GuillaumeRossolini/griotte/doc/img/2024-09-30_overview.jpg

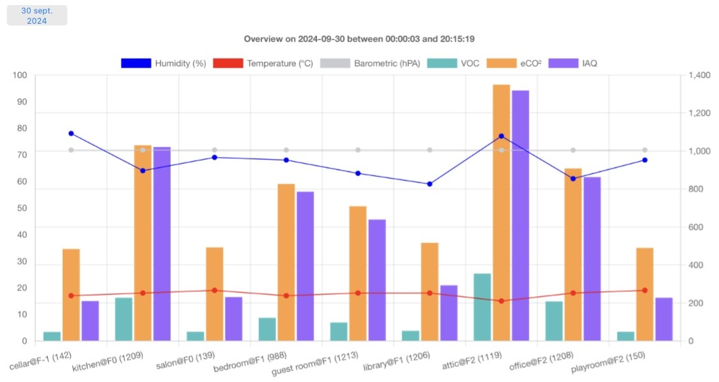
doc/img/2024-09-30_overview.jpg
