GuillaumeRossolini/griotte/doc/img/2025-03-06_overview.png

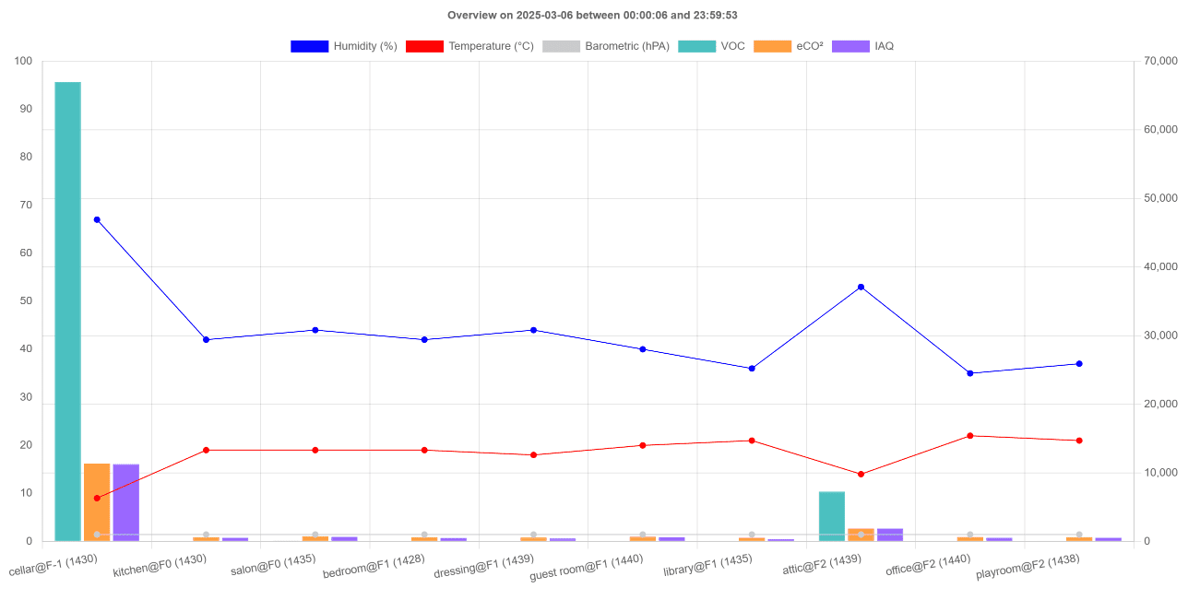
doc/img/2025-03-06_overview.png
