GuillaumeRossolini/griotte/doc/img/2025-03-07_logs.png

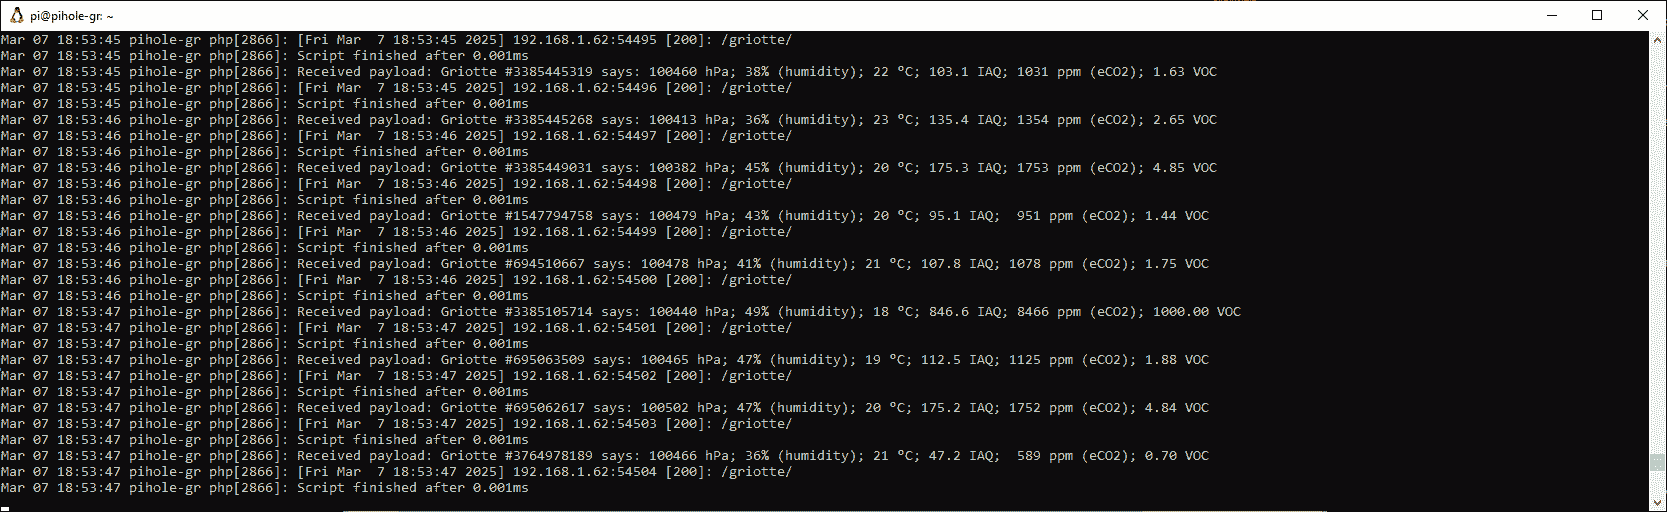
doc/img/2025-03-07_logs.png
