GuillaumeRossolini/griotte/doc/img/btop_16d.png

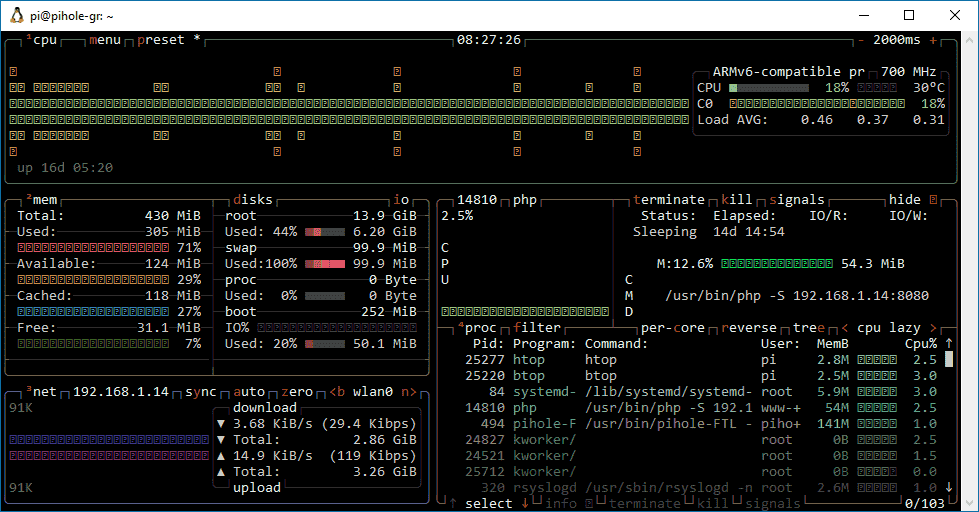
doc/img/btop_16d.png
