GuillaumeRossolini/griotte/doc/img/htop_16d.png

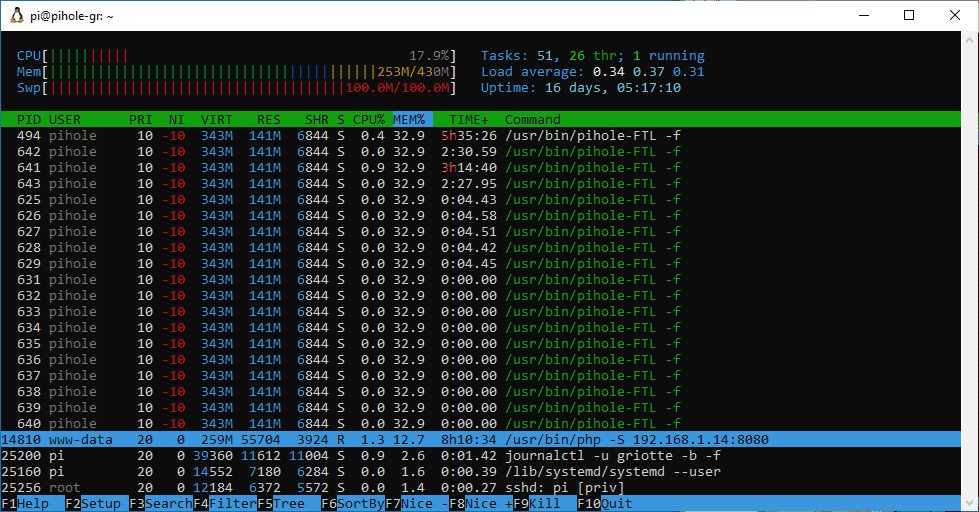
doc/img/htop_16d.png
