GuillaumeRossolini/griotte/doc/img/htop_fresh.png

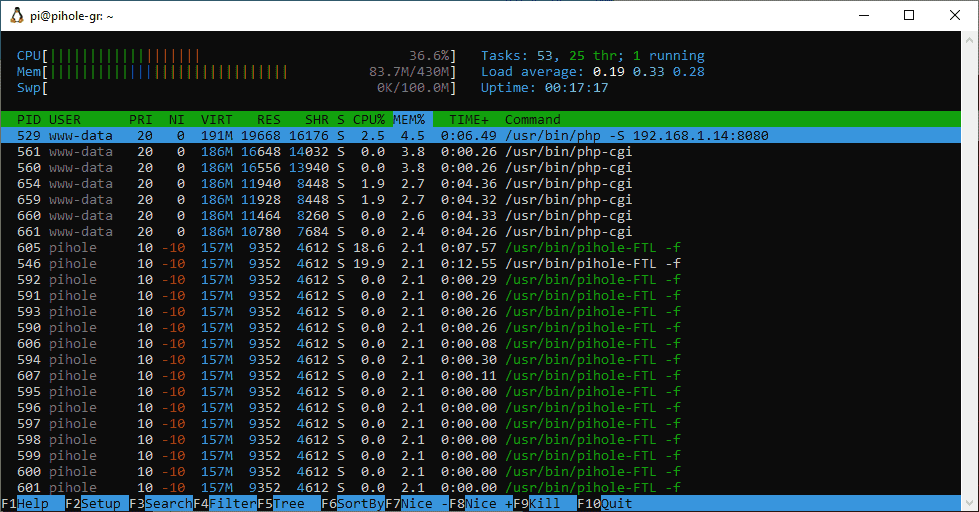
doc/img/htop_fresh.png
