GuillaumeRossolini/griotte/doc/img/mesh.png

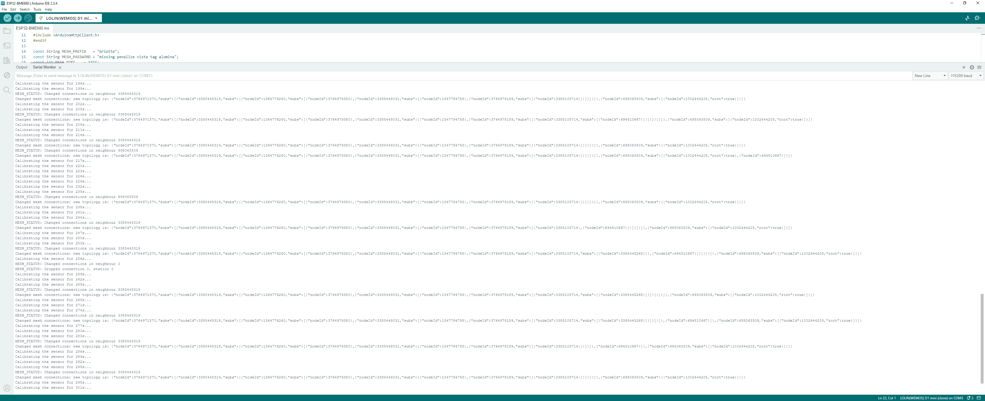
doc/img/mesh.png
