GuillaumeRossolini/griotte/doc/img/src/2025-03-07_overview.png

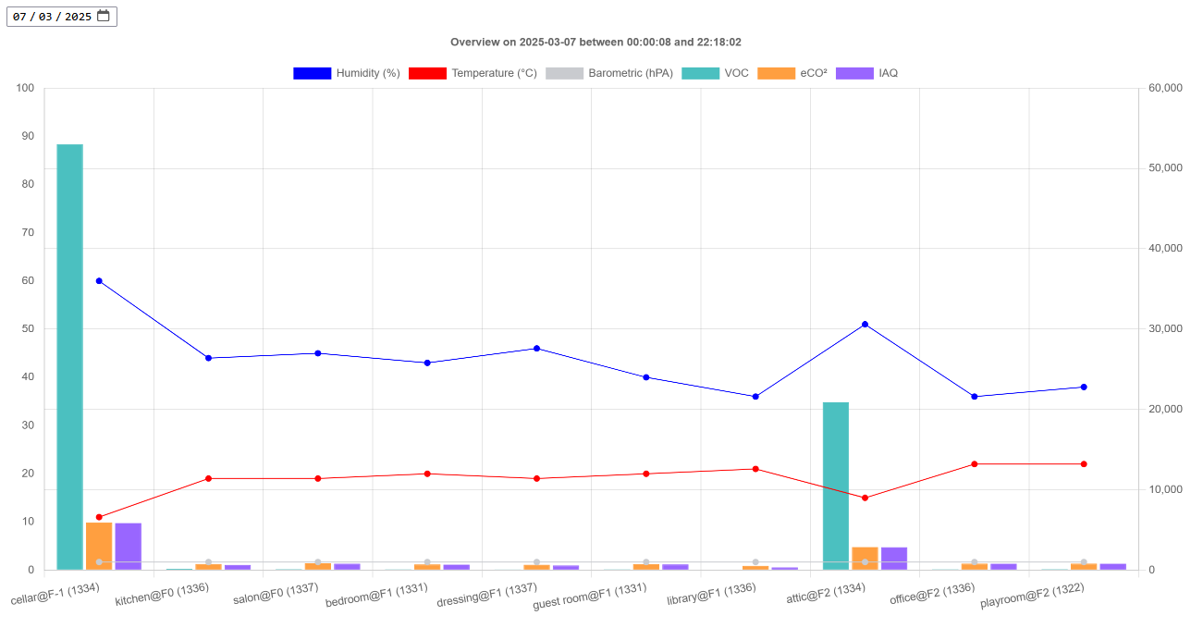
doc/img/src/2025-03-07_overview.png
