GuillaumeRossolini/griotte/doc/img/src/2025-03-30_logs.png

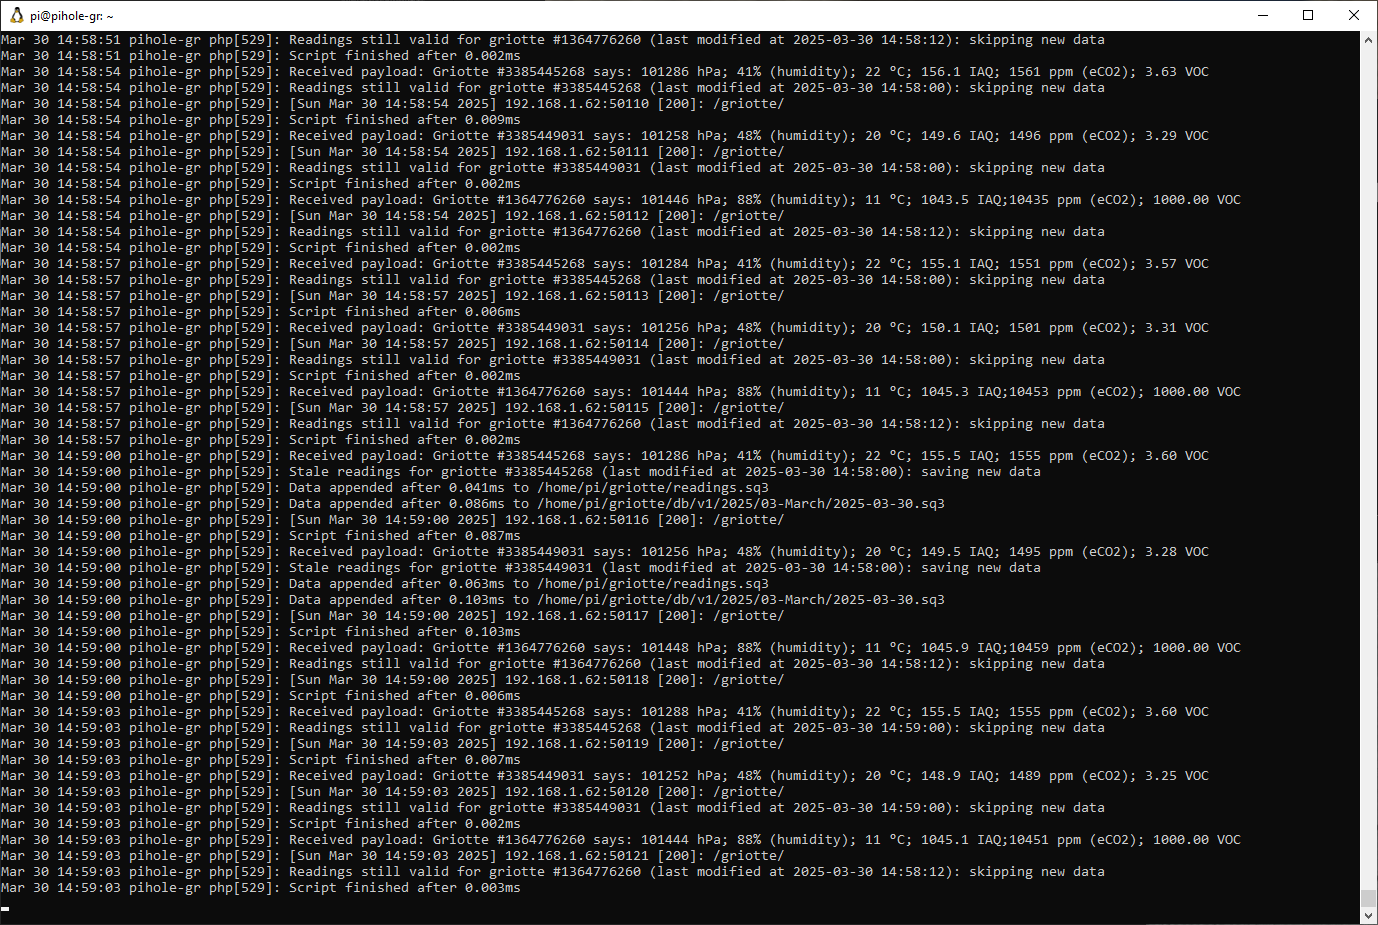
doc/img/src/2025-03-30_logs.png
