GuillaumeRossolini/griotte/doc/img/src/diagram.png

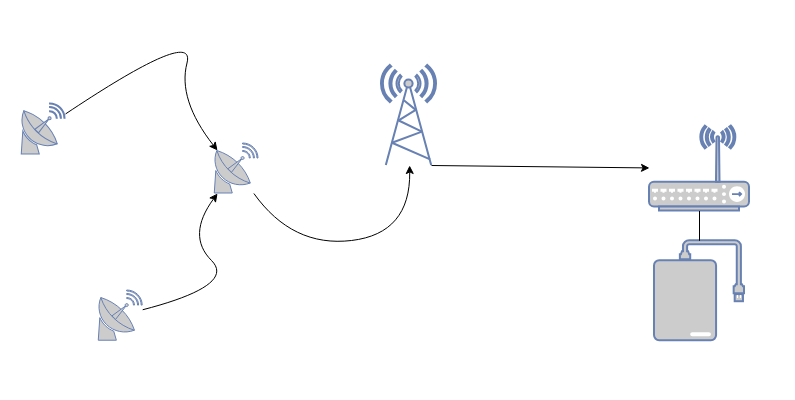
doc/img/src/diagram.png
