GuillaumeRossolini/griotte/doc/img/src/griotte_orig.jpeg

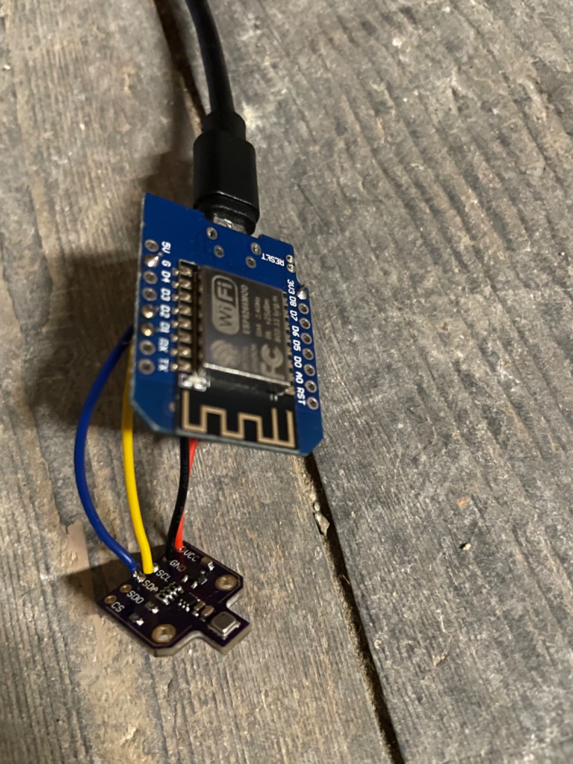
doc/img/src/griotte_orig.jpeg
