GuillaumeRossolini/griotte/tests/colors.html

Node | Floor | Earliest | Latest | Readings | Free heap | Reboots | Uptime | AVG Atmo | AVG Hum | AVG Temp | AVG Quality
9 nodes | | | | 6219 total | | 2 total
archives | 2 | 00:00:57 | 15:53:40 | 883 | 24 Ko | 0 | 27 h | 1010 hPa | 29 % | 34 °C | 91 %
attic | 2 | 00:00:58 | 15:53:34 | 860 | 16 Ko | 1 | 23 h | 1010 hPa | 31 % | 31 °C | 19 %
office | 2 | 00:00:57 | 15:54:00 | 866 | 22 Ko | 0 | 27 h | 1010 hPa | 35 % | 30 °C | 75 %
playroom | 2 | 00:00:54 | 12:10:51 | 737 | 28 Ko | 1 | 22 h | 1011 hPa | 35 % | 30 °C | 50 %
bedroom | 1 | 00:00:36 | 12:10:51 | 721 | 28 Ko | 0 | 26 h | 1011 hPa | 41 % | 27 °C | 86 %
guest room | 1 | 00:00:57 | 15:54:33 | 811 | 26 Ko | 0 | 27 h | 1011 hPa | 42 % | 27 °C | 69 %
heater | 0 | 00:00:19 | 12:10:51 | 730 | 28 Ko | 0 | 43 h | 1011 hPa | 37 % | 31 °C | 94 %
salon | 0 | 08:20:10 | 15:53:39 | 380 | 24 Ko | 0 | 7 h | 1011 hPa | 35 % | 31 °C | 89 %
cellar | -1 | 08:19:41 | 12:10:50 | 231 | 31 Ko | 0 | 3 h | 1014 hPa | 40 % | 29 °C | 92 %
