GuillaumeRossolini/griotte/(commit log)

2024-08-20 First commit; working with 3 devices
2024-08-20 Draft for the BME680 sensor
2024-09-17 With working ESP32 & ESP8266; with working BME680; With working iot mesh; With working home WiFi bridge; With working HTTP POST
2024-09-20 With a graph for each sensor (=room)
2024-09-23 Fixed issues with date filtering; added a form for user interaction with the date
2025-03-05 Fixed log traces: some were broken, none worked with syslog
2025-03-30 Improved syslog traces
2025-03-30 Commented the constants in the shared script; Enabled all syslog traces for better visibility
2025-03-30 Improved traces and comments
2025-03-30 Added a screenshot of htop on the Raspberry Pi Zero W; Updated the screenshot of the logs to reflect recent changes (plus, the old screenshot wasn't showing anything useful)
2025-03-30 Removed duplicate touching the run-file; Removed manually touching the DB file (sqlite does this anyway); Simplified traces with unique messages
2025-04-21 Added intermediary CSV buffer, thus grouping the SQL inserts at 5 minute intervals and increasing observability
2025-04-26 Some light fixes in the embedded program: removed an unused variable, enabled some traces and removed others
    [ESP32-BME680.ino]
2025-05-03 Removed String conversions to avoid the heap; Added logic for sensor failures; Added iAQ accuracy to the serial logs; Added missing call to http.stop()
    [ESP32-BME680.ino]
2025-05-08 Removed yet more heap possible issues
    [ESP32-BME680.ino]
2025-05-08 More C memory fixes; Moved the iAQ graph to a % representation; Added a config file
    [ESP32-BME680.ino]
2025-05-11 Added comments for how to read sensor values; Added log of the number of rows imported from CSV; Removed useless code
2025-05-11 Added bounds for sensor values triggering a microcontroller restart (experimental)
2025-05-17 Made the webapp more easily shareable, and traces
2025-05-17 Fixed some errors with the ESP32 gateway
    [ESP32-BME680.ino]
2025-06-08 Major changes (this will be a messy commit): split the code in the main() and loop() functions to make it more readable; Added an event handler for WiFi events (the WAN events from the mesh library a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
    [ESP32-BME680.ino]
2025-07-06 Switched video to Peertube
2025-08-17 Added the notion of 'typology' to each HTTP request to help differentiate uploads (metadata, sensor brand); Added a number of retries for each HTTP request to help with temporary latency issues; Read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
    [ESP32-BME680.ino, griotte_creds_defaults.h]
2025-10-06 Changed the WiFi scanning method; changed some traces
2025-11-22 Changed the payload format to add node IP address on the mesh + number of mesh subscribers + mesh stability index - adjusted database structure + queries + HTTP API to match this change - updated pai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
    [ESP32-BME680.ino, griotte_creds_defaults.h]
2025-11-23 Split the web server into two to reserve a port for the API and another for the pretty graphs, so that the ESP32 doesn't have to wait when we load the graphs (this cascades into mesh timeouts and evi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
2025-11-23 Filled in all the traces for debugging purposes (over SERIAL only, no change of the network messages)
2025-11-23 Changed the program behaviour to better reflect how the web server was supposed to behave: * when a payload is saved, the HTTP status code is 201, not 200 * updated the sequence of checks for the HTT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
2025-11-23 * Made PHP constants out of the main variables for clarity: GRIOTTE_SERIAL_NB, GRIOTTE_PAYLOAD_STRUCT and GRIOTTE_PAYLOAD_RAW * Added proper handling of the 'typology' payload type * Made PHP constan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
2026-05-08 Updated all the dependencies, particularly AsyncTCP by dvarrel was the one holding ESP32 back to below v3.0
2026-05-10 Naive attempt at fixing this stability issue
    [ESP32-BME680.ino]
2026-05-14 Added the ability to add several ESP32's to the mesh for testing purposes, but still only one of them is root and can forward HTTP messages
2026-05-16 This lets me add an observer ESP32 in the mesh that I can hook up to a computer to tail the serial console
2026-05-24 Added to the wishlist again; Switched iAQ presentation to 'higher values are better'
2026-05-25 Added an example of how to deploy the webapp in WSL; I'll be using this for development iterations on a desktop machine while leaving the Raspberry Pi to handle the same mesh messages on its tagged v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
2026-05-25 Forgot to document this big todo item that currently limits the size of the mesh to 6 sensors
2026-05-25 Updated the Arduino dependencies; fixed some typos in my WSL documentation
    [griotte_creds_defaults.h]
2026-05-25 Switched the main HTTP server to nginx + php-fpm on the development swarm (not fully tested yet); beware that nginx:alpine is 63MB in size, while php:8-cli-alpine was 138MB and php:8-fpm-trixie is 51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
2026-05-30 Finished the switch from php -S to nginx & php-fpm; Added resource constraints for each service; Added .status and .ping endpoints for each php-fpm backend (see nginx config); Added some headers to i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
2026-05-30 Rolling back some optimistic tweaks that didn't pan out
    [ESP32-BME680.ino]
2026-05-31 Inconsequential update to serial traces format
2026-05-31 Slightly better in case of duplicates
2026-05-31 iAQ data is treated as void so long as the sensor is warming up (5 minutes startup sequence for BME680); improved the graphs by using a time series plugin so that gaps in the data are visible
2026-05-31 More todo’s
2026-06-01 Added one replica per service to be able to update them in sequence; Split the nginx forwarding rules to two different conf files; Switched the JS files to nginx
2026-08-12 Fixed typo for ESP8266; Fixed checking for root node availability and reboot if not
    [ESP32-BME680.ino]
2026-08-29 Added a way for nodes to say hello to the root node as soon as they find each other; fixed a typo in a printf that caused a core panic (Load access fault)
    [ESP32-BME680.ino]
